bit4man/dcload/README.md

# dcload
DC Load circuitry, code and more

DC Load circuit as developed by ScullCom (www.skullcom.uk). Borrowed project to implement on my own with a few modifications.
