bit4man/dcload/DC_Load_front_panel_Template.pdf

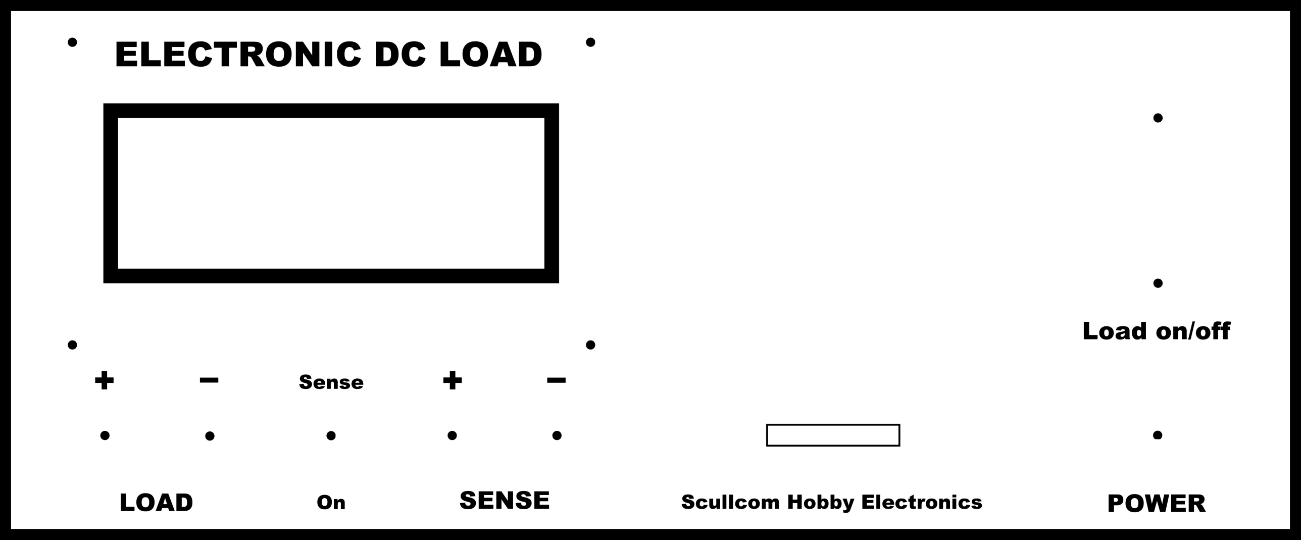
[picture p1: page 1]
