bit4man/dcload/Bom_7527446.xlsx

Manufacturer Part Number | Manufacturer | Digi-Key Part Number | Customer Reference | Reference Designator | Packaging | Description | Quantity | Unit Price | TOTAL
MCP3426A0-E/SN | Microchip Technology | MCP3426A0-E/SN-ND |  |  | Tube | IC ADC 16BIT I2C 15SPS 8SOIC | 1 | 2.77 | 2.77
MCP4725A0T-E/CH | Microchip Technology | MCP4725A0T-E/CHCT-ND |  |  | Cut Tape (CT) | IC DAC 12BIT W/I2C SOT23A-6 | 1 | 1.02 | 1.02
LM35DT/NOPB | Texas Instruments | LM35DT/NOPB-ND |  |  | Tube | SENSOR TEMP ANLG VOLT TO-220-3 | 1 | 2.9 | 2.9
MCP79410-I/SN | Microchip Technology | MCP79410-I/SN-ND |  |  | Tube | IC RTC CLK/CALENDAR I2C 8-SOIC | 1 | 0.95 | 0.95
ICL7660CPAZ | Intersil | ICL7660CPAZ-ND |  |  | Tube | IC REG SWTCHD CAP INV RATIO 8DIP | 1 | 1.74 | 1.74
OPA277PA | Texas Instruments | OPA277PA-ND |  |  | Tube | IC OPAMP GP 1MHZ 8DIP | 1 | 3.37 | 3.37
4N25 | Lite-On Inc. | 160-1300-5-ND |  |  | Tube | OPTOISO 2.5KV TRANS W/BASE 6DIP | 1 | 0.48 | 0.48
SN74LVC2G14DBVR | Texas Instruments | 296-13010-1-ND |  |  | Cut Tape (CT) | IC INVERTER DUAL SHMT-T SOT-23-6 | 1 | 0.55 | 0.55
LM431ACZX | ON Semiconductor | LM431ACZXCT-ND |  |  | Cut Tape (CT) | IC VREF SHUNT ADJ TO92-3 | 1 | 0.42 | 0.42
MBR41H100CTG | ON Semiconductor | MBR41H100CTGOS-ND |  |  | Tube | DIODE ARRAY SCHOTTKY 100V TO220 | 1 | 1.62 | 1.62
1N4007-TP | Micro Commercial Co | 1N4007-TPMSCT-ND |  |  | Cut Tape (CT) | DIODE GEN PURP 1KV 1A DO41 | 1 | 0.11 | 0.11
UF5408-E3/54 | Vishay Semiconductor Diodes Division | UF5408-E3/54GICT-ND |  |  | Cut Tape (CT) | DIODE GEN PURP 1KV 3A DO201AD | 1 | 0.59 | 0.59
1N4148 | ON Semiconductor | 1N4148FS-ND |  |  | Bulk | DIODE GEN PURP 100V 200MA DO35 | 2 | 0.1 | 0.2
EN11-HSM1AF15 | TT Electronics/BI | 987-1188-ND |  |  | Tray | ENCODER 11MM ROTARY SW TOP ADJ | 1 | 1.22 | 1.22
PV36W201C01B00 | Bourns Inc. | 490-2879-ND |  |  | Bulk | TRIMMER 200 OHM 0.5W TH | 1 | 1.5 | 1.5
PV36W103C01B00 | Bourns Inc. | 490-2875-ND |  |  | Bulk | TRIMMER 10K OHM 0.5W TH | 2 | 1.5 | 3
3296W-1-203LF | Bourns Inc. | 3296W-203LF-ND |  |  | Tube | TRIMMER 20K OHM 0.5W PC PIN | 1 | 2.41 | 2.41
3296W-1-504LF | Bourns Inc. | 3296W-504LF-ND |  |  | Tube | TRIMMER 500K OHM 0.5W PC PIN | 1 | 2.41 | 2.41
MRS25000C1000FCT00 | Vishay BC Components | BC3953CT-ND |  |  | Cut Tape (CT) | RES 100 OHM 0.6W 1% AXIAL | 7 | 0.29 | 2.03
LR1F1K0 | TE Connectivity Passive Product | A105951CT-ND |  |  | Cut Tape (CT) | RES 1.00K OHM 0.6W 1% AXIAL | 5 | 0.14 | 0.7
MRS25000C2001FRP00 | Vishay BC Components | PPC2.00KZCT-ND |  |  | Cut Tape (CT) | RES 2K OHM 0.6W 1% AXIAL | 1 | 0.29 | 0.29
MRS25000C2201FCT00 | Vishay BC Components | BC4060CT-ND |  |  | Cut Tape (CT) | RES 2.2K OHM 0.6W 1% AXIAL | 5 | 0.29 | 1.45
MRS25000C1002FRP00 | Vishay BC Components | PPC10.0KZCT-ND |  |  | Cut Tape (CT) | RES 10K OHM 0.6W 1% AXIAL | 7 | 0.29 | 2.03
LR1F47K | TE Connectivity Passive Product | A105961CT-ND |  |  | Cut Tape (CT) | RES 47.0K OHM 0.6W 1% AXIAL | 5 | 0.14 | 0.7
LR1F100K | TE Connectivity Passive Product | A105945CT-ND |  |  | Cut Tape (CT) | RES 100K OHM 0.6W 1% AXIAL | 1 | 0.14 | 0.14
MRS25000C1803FCT00 | Vishay BC Components | BC4581CT-ND |  |  | Cut Tape (CT) | RES 180K OHM 1% 0.6W AXIAL | 1 | 0.29 | 0.29
MRS25000C2703FCT00 | Vishay BC Components | BC4098CT-ND |  |  | Cut Tape (CT) | RES 270K OHM 0.6W 1% AXIAL | 1 | 0.29 | 0.29
MRS25000C3303FCT00 | Vishay BC Components | BC4129CT-ND |  |  | Cut Tape (CT) | RES 330K OHM 0.6W 1% AXIAL | 1 | 0.29 | 0.29
MRS25000C4703FCT00 | Vishay BC Components | BC4180CT-ND |  |  | Cut Tape (CT) | RES 470K OHM 0.6W 1% AXIAL | 1 | 0.29 | 0.29
MRS25000C1804FRP00 | Vishay BC Components | PPC1.80MZCT-ND |  |  | Cut Tape (CT) | RES 1.8M OHM 0.6W 1% AXIAL | 1 | 0.31 | 0.31
MRS25000C4704FCT00 | Vishay BC Components | BC4181CT-ND |  |  | Cut Tape (CT) | RES 4.7M OHM 0.6W 1% AXIAL | 1 | 0.31 | 0.31
MRS25000C9090FRP00 | Vishay BC Components | PPC909ZCT-ND |  |  | Cut Tape (CT) | RES 909 OHM 0.6W 1% AXIAL | 1 | 0.29 | 0.29
MFP-25BRD52-910R | Yageo | 910ADCT-ND |  |  | Cut Tape (CT) | RES 910 OHM 1/4W 0.1% AXIAL | 1 | 0.46 | 0.46
MFP-25BRD52-9K1 | Yageo | 9.1KADCT-ND |  |  | Cut Tape (CT) | RES 9.1K OHM 1/4W 0.1% AXIAL | 1 | 0.46 | 0.46
MFP-25BRD52-20K | Yageo | 20KADCT-ND |  |  | Cut Tape (CT) | RES 20K OHM 1/4W 0.1% AXIAL | 2 | 0.46 | 0.92
YR1B1M0CC | TE Connectivity Passive Product | A105943CT-ND |  |  | Cut Tape (CT) | RES 1.00M OHM 1/4W 0.1% AXIAL | 2 | 0.75 | 1.5
PWR220T-35-R100F | Bourns Inc. | PWR220T-35-R100F-ND |  |  | Tube | RES 0.1 OHM 35W 1% TO220 | 1 | 4.29 | 4.29
CC45SL3FD100JYNNA | TDK Corporation | 445-15987-ND |  |  | Bulk | CAP CER 10PF 3KV SL RADIAL | 2 | 0.35 | 0.7
K101K10X7RH5UH5 | Vishay BC Components | BC2658CT-ND |  |  | Cut Tape (CT) | CAP CER 100PF 100V X7R RADIAL | 1 | 0.17 | 0.17
R82EC1100DQ50K | KEMET | 399-5865-1-ND |  |  | Cut Tape (CT) | CAP FILM 1000PF 10% 100VDC RAD | 1 | 0.29 | 0.29
R82EC3100DQ70J | KEMET | 399-5453-1-ND |  |  | Cut Tape (CT) | CAP FILM 0.1UF 5% 100VDC RADIAL | 14 | 0.201 | 2.814
TAP105K025BRS | AVX Corporation | 478-8949-1-ND |  |  | Cut Tape (CT) | CAP TANT 1UF 25V 10% RADIAL | 1 | 0.76 | 0.76
T350E106K025AT7301 | KEMET | 399-9936-1-ND |  |  | Cut Tape (CT) | CAP TANT 10UF 25V 10% RADIAL | 6 | 1.84 | 11.04
UFW1E470MDD1TD | Nichicon | 493-10997-1-ND |  |  | Cut Tape (CT) | CAP ALUM 47UF 20% 25V RADIAL | 1 | 0.23 | 0.23
UHE1E101MED | Nichicon | 493-1548-ND |  |  | Bulk | CAP ALUM 100UF 20% 25V RADIAL | 2 | 0.3 | 0.6
UKL1E471KHD | Nichicon | 493-13401-ND |  |  | Bulk | CAP ALUM 470UF 10% 25V RADIAL | 1 | 0.85 | 0.85
AB38T-32.768KHZ | Abracon LLC | 535-9034-ND |  |  | Bulk | CRYSTAL 32.7680KHZ 12.5PF T/H | 1 | 0.17 | 0.17
B2B-XH-A(LF)(SN) | JST Sales America Inc. | 455-2247-ND |  |  | Bulk | CONN HEADER XH TOP 2POS 2.5MM | 5 | 0.15 | 0.75
MC7805ACTG | ON Semiconductor | MC7805ACTGOS-ND |  |  | Tube | IC REG LINEAR 5V 1A TO220AB | 1 | 0.52 | 0.52
PN2222A | Central Semiconductor Corp | PN2222ACS-ND |  |  | Bulk | TRANS NPN 40V 0.8A TO-92 | 4 | 0.55 | 2.2
2N3904 | Central Semiconductor Corp | 2N3904CS-ND |  |  | Bulk | TRANS NPN 40V TO-92 | 1 | 0.44 | 0.44
LCR-U02004DSF-WH | Lumex Opto/Components Inc. | 67-2094-ND |  |  | Box | LCD MODULE 20X4 CHAR TRNSFL STN | 1 | 28.64 | 28.64
EN11-HNM1AF15 | TT Electronics/BI | 987-1185-ND |  |  | Tray | ENCODER 11MM ROTARY TOP ADJUST | 1 | 0.96 | 0.96
PNP300JR-73-0R1 | Yageo | 0.1AECT-ND |  |  | Cut Tape (CT) | RES 0.1 OHM 3W 5% AXIAL | 4 | 0.42 | 1.68
01110005MR | Littelfuse Inc. | F043CT-ND |  |  | Cut Tape (CT) | FUSE CLIP CARTRIDGE 250V 10A PCB | 2 | 0.33 | 0.66
5HF 5-R | Bel Fuse Inc. | 507-1203-ND |  |  | Box | FUSE CERAMIC 5A 250VAC 5X20MM | 1 | 0.29 | 0.29
27899 | Parallax Inc. | 27899PAR-ND |  |  | Bulk | SWITCH KEYPAD 16 KEY NON-ILLUM | 1 | 6.5 | 6.5
ATS-EXL1-254-R0 | Advanced Thermal Solutions Inc. | ATS2193-ND |  |  | Bulk | HEATSINK AL6063 254X100X10MM | 1 | 16.38 | 16.38
9284R/B | E-Z-Hook | 461-1215-ND |  |  | Bulk | BANANA JACK PNL MT SET/2 RED/BLK | 1 | 3.4 | 3.4
3643 | Adafruit Industries LLC | 1528-2553-ND |  |  | Bulk | 2.1MM DC POWER JACK WITH ROCKER | 1 | 1.95 | 1.95
1-2199298-1 | TE Connectivity AMP Connectors | A120346-ND |  |  | Tube | CONN IC DIP SOCKET 6POS TIN | 1 | 0.21 | 0.21
808-AG11D-ESL-LF | TE Connectivity AMP Connectors | A121607-ND |  |  | Tube | CONN IC DIP SOCKET 8POS GOLD | 2 | 1.45 | 2.9
MC7812ACTG | ON Semiconductor | MC7812ACTGOS-ND |  |  | Tube | IC REG LINEAR 12V 1A TO220AB | 1 | 0.52 | 0.52
REF5040AID | Texas Instruments | 296-22207-5-ND |  |  | Tube | IC VREF SERIES 4.096V 8SOIC | 1 | 3.5 | 3.5
AD8630ARZ-REEL7 | Analog Devices Inc. | AD8630ARZ-REEL7CT-ND |  |  | Cut Tape (CT) | IC OPAMP ZRO-DRFT 2.5MHZ 14SOIC | 1 | 6.98 | 6.98
TAP107K020CCS | AVX Corporation | 478-1847-ND |  |  | Bulk | CAP TANT 100UF 20V 10% RADIAL | 2 | 3.63 | 7.26
TOTAL |  |  |  |  |  |  |  |  | 147.664
