bit4man/dcload/dcload part list.ods

id | type | Inventory | Descripton | Datasheet | Order
R1 | 10KOhm
R2 | 10KOhm
R3 | 1KOhm
R4 | 10KOhm
R5 | 100 Ohm
R6 | 9K Ohm |  | Precision 0.1%
R7 | 10K Ohm
R8 | 1KOhm
R9 | 100 Ohm
R10 | 47K Ohm
R11 | 10KOhm
R12 | 47K Ohm
R13 | 20K Ohm
R14 | 909 Ohm |  | Precision 0.1%
R15 | 100 Ohm
R16 | 10K Ohm
R17 | 0.1 Ohm |  | 1% 35W
R18 | 4.7K Ohm
R19 | 10KOhm
R20 | 10KOhm
R21 | 100 Ohm
R22 | 0.1 Ohm
R23 | 0.1 Ohm
R24 | 0.1 Ohm
R25 | 0.1 Ohm
R26 | 47K Ohm
R27 | 47K Ohm
R28 | 10KOhm
R29 | 10KOhm
R30 | 2.2K Ohm
R31 | 20K Ohm
R32 | 47K Ohm
R33 | 1M Ohm
R34 | 1M Ohm
R35 | 2.2K Ohm
R36 | 2.2K Ohm
R37 | 2.2K Ohm
R38 | 2.2K Ohm
R39 | 1.8M Ohm
R40 | 4.7M Ohm
R41 | 330K Ohm
R42 | 100K Ohm
R43
R44 | 470K Ohm
R45 | 1KOhm
R46 | 270K Ohm
R47
R48
R49
C1 | 470uF
C2 | 100nF
C3 | 100pF
C4 | 100uF
C5 | 100nF
C6 | 220uF
C7 | 100nF
C8 | 47uF
C9 | 100nF
C10 | 10uF
C11 | 100nF
C12 | 100nF
C13 | 10uF
C14 | 10uF
C15 | 100nF
C16 | 100nF
C17 | 100nF
C18 | 100nF
C19 | 1nF
C20 | 20uF
C21 | 100nF
C22 | 10pF
C23 | 10pF
C24 | 1uF
C25 | 10uF
C26 | 100uF
C27 | 100nF
C28 | 1uF
C29 | 100nF
C30 | 10uF
C31
C32
C33
C34
C35
U1 | LM7812CT
U2 | LM7805CT
U3 | Arduino |  | Arduino Nano
U4 | LM35DT |  | Temperature Monitor
U5 | MCP4725
U6 | MCP3426
U7 | AD8630
U8 | MCP79410 |  | RTC
U9 | REF5040
U10 | 4N25 |  | OptoCobler
U11 | 74LVC2G14
U12 | ICL7660 |  | Or LTC1046
U13 | OPA277PA
U14 | LM431
D1 | IN4148
D2 | 1N4007
D3 | UF540B
D4 | 1N4148
D5 | MBR41H100CT
D6
Q1 | TIP122
Q2 | BUK956R1-100E
Q3 | BUK956R1-100E
Q4 | BUK956R1-100E
Q5 | BUK956R1-100E
Q6 | PN2222A
Q7 | PN2222A
Q8 | PN2222A
Q9 | PN2222A
Q10 | 2N3904
Q11
Q12
Q13
Q14
Q15
J1 | Scope Test
J2 | DC In
J3
J4 | Pin GND
J5 | Pin +12V
J6 | Trigger Button
J7
J8 | Trigger Input
J9
J10 | Pin Mosfet |  | Mosfet Drive test
J11
J12
J13 | FAN
J14 | Pin A0
J15 | Sense Input
J16
J17
SW1 | Rotary Encoder |  | 20 positions per turn
SW2 | Power Switch
SW3
SW4
SW5
SW6
LCD1 | LCD I2C 20x4
RV1 | 500K Ohm
RV2 | 20K Ohm
RV3 | 10KOhm
RV4 | 200 Ohm
RV5 | 10KOhm
RV6
RV7
TP1 | SDA |  | Test Pin
TP2 | SCL |  | Test Pin
TP3 | TEST U5 |  | Test Pin
TP4 | TEST 5v |  | Test Pin
TP5 | TEST GND |  | Test Pin
Y1 | 32.788Khz
