bit4man/dcload/DC_Load_LCD_wiring.pdf

# SCULLCOM HOBBY ELECTRONICS

## Electronic DC Load – Version 9.2

## LCD I²C Wiring Connections

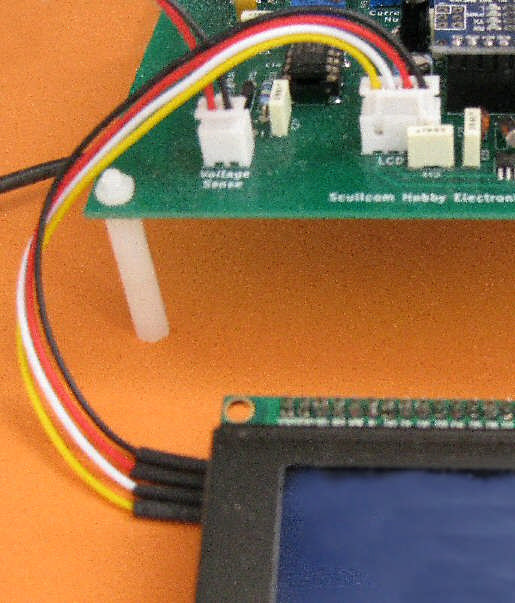
[picture p2: figure]

The LCD has an I²C module fitted. The wiring are as follows: Black - to GND
Red - to VCC
White - to SDA
Yellow - to SCL

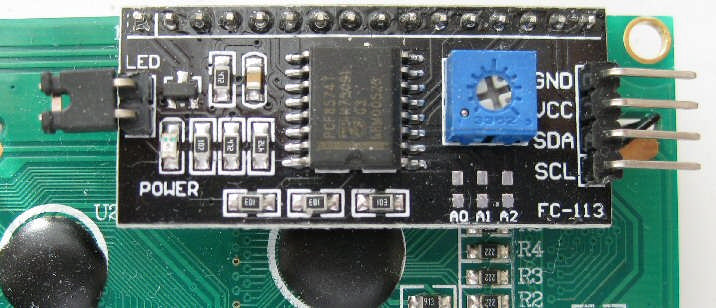
[picture p3: figure]
