bit4man/dcload/DC_Load_Rotary_Encoder_wiring.pdf

# SCULLCOM HOBBY ELECTRONICS

## Electronic DC Load – Version 9.2

## Rotary Encoder Wiring Diagram

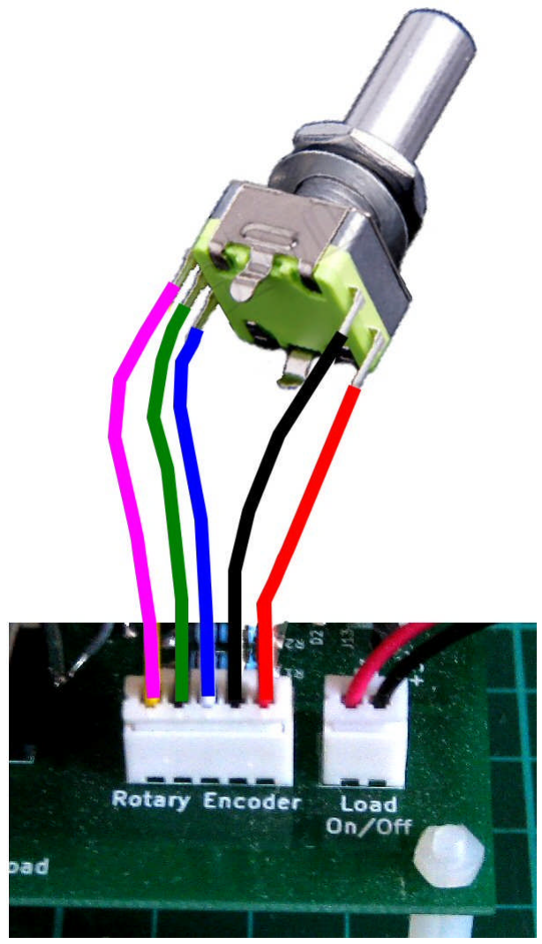
[picture p4: figure]

Typical wiring for the Rotary Encoder connections to the PCB socket/plug

Due to some variations with rotary encoders, if you find the rotary encoder is not responding correctly with the above wiring connections, switch around the purple and blue wire connections on the rotary encoder.

Red and Black wires go to the momentary push button switch on the rotary encoder.
