bit4man/dcload/(commit log)

2018-03-23 Initial setup
    [Bom_7527446.xlsx, dcload part list.ods, dcload part list.xlsx, newark_quote_template.xls]
2018-03-23 Added Arduino code
